darkosancanin/g_and_c_speaker/(commit log)

2015-05-22 Added Dallas Temperature library.
2015-05-23 Added all libraries to test memory pressure. Will be pushing it!.
2015-05-25 Added play current time.
2015-05-27 Fixed IR freezing bug.
    [g_and_c_speaker.ino]
2015-05-27 Fixed bug with lookup table offset.
    [WavPlayer.cpp, g_and_c_speaker.ino]
2015-05-29 Updated pin connections.
